inventowiz/frosty-flake-clone/frosty-flake-clone.kicad_pcb

## KiCad design frosty-flake-clone.kicad_pcb (2020-03-29)

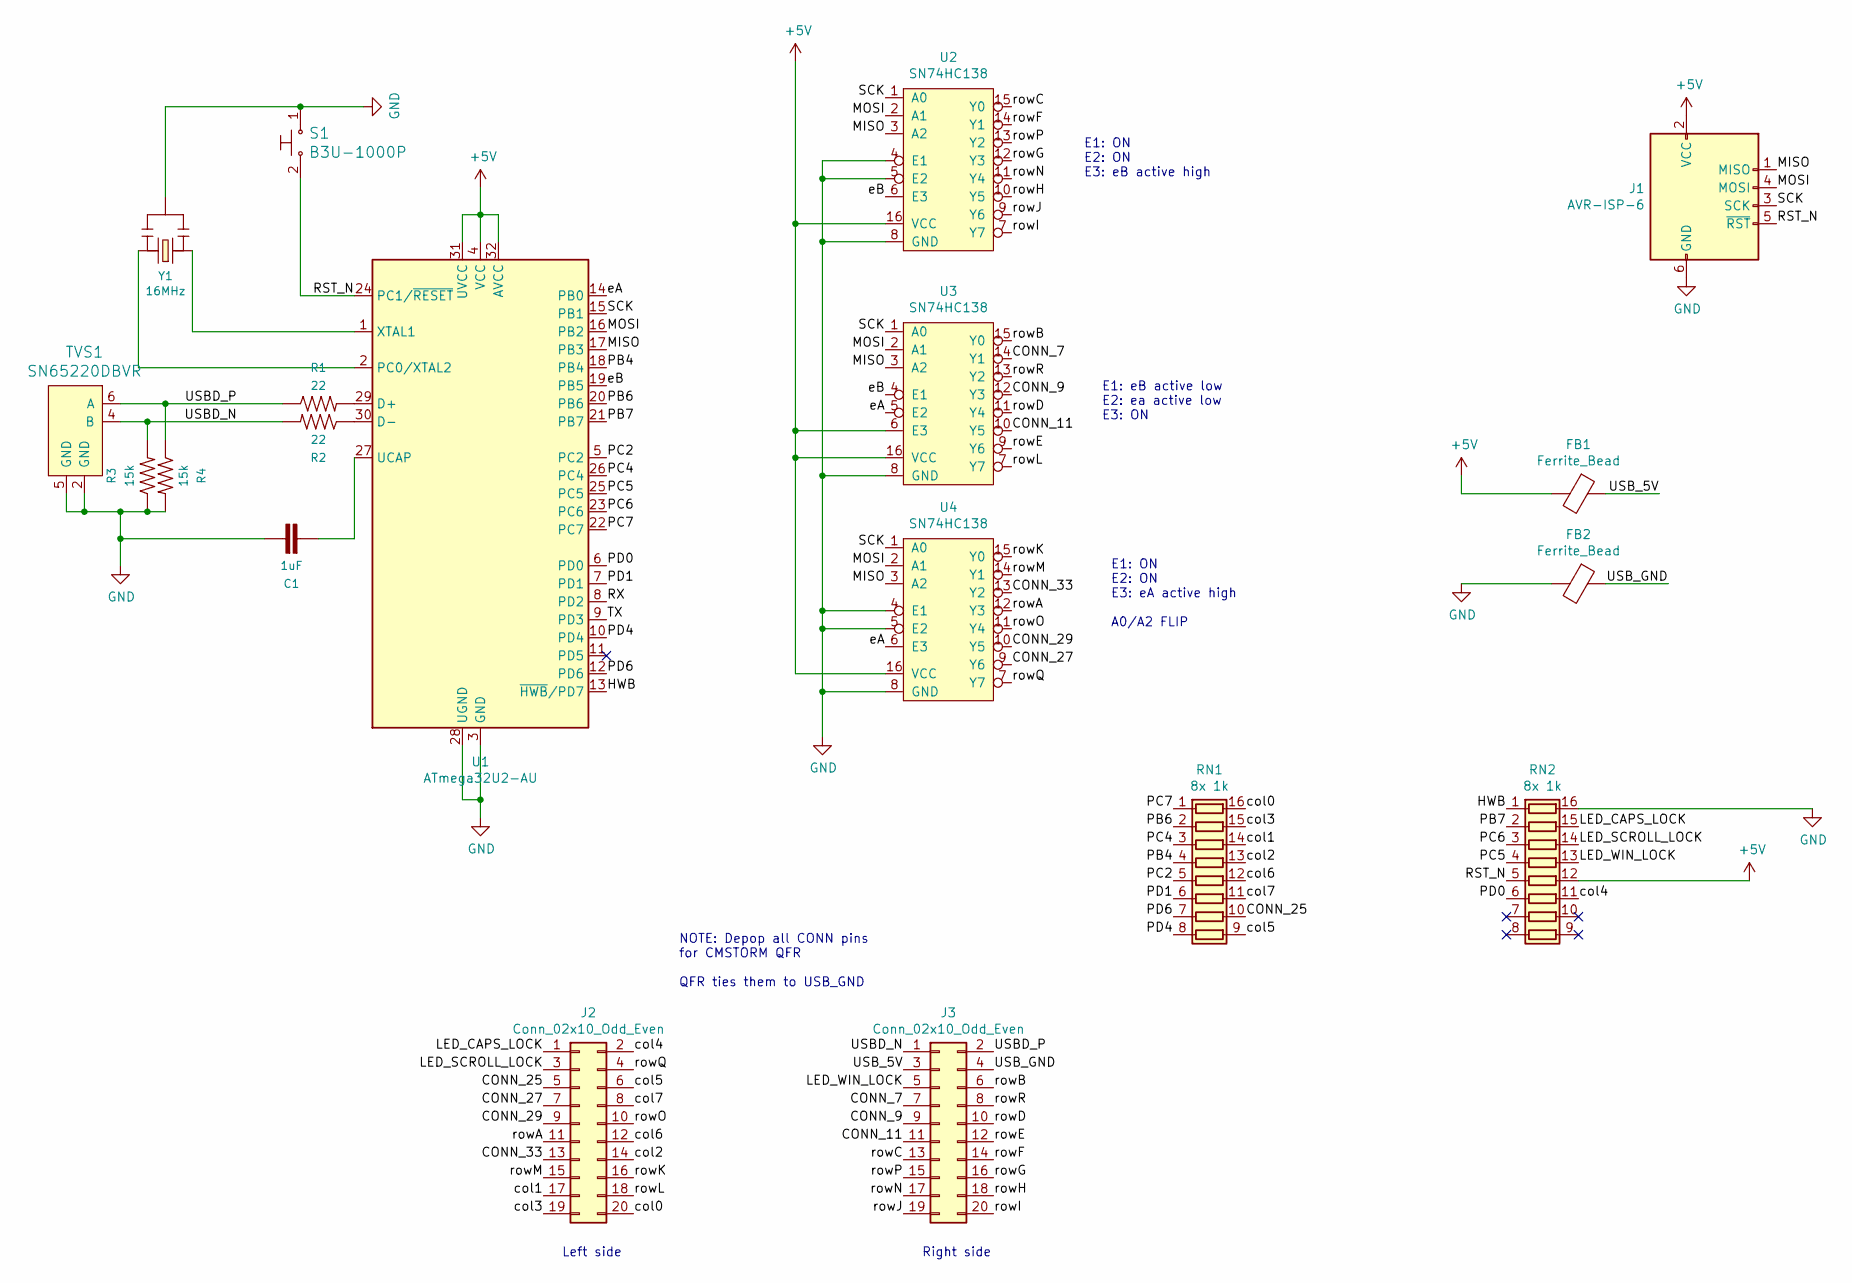
[picture p1: schematic frosty-flake-clone.sch]

Parts:
C1: 1uF; 0805
FB1, FB2: Ferrite_Bead; 0603
J1: AVR-ISP-6; 2X3
J2, J3: Conn_02x10_Odd_Even; PinHeader_2x10_P2.00mm_Vertical
R1, R2: 22; 0603
R3, R4: 15k; 0603
RN1, RN2: 8x 1k; R_Array_Convex_8x0602
S1: B3U-1000P; Switch_Tactile_SMD_B3U-1000P; MPN B3U-1000P; Digi-Key_PN SW1020CT-ND
TVS1: SN65220DBVR; SOT-23-6; MPN SN65220DBVR; Digi-Key_PN 296-9694-1-ND
U1: ATmega32U2-AU; TQFP-32_7x7mm_P0.8mm
U2, U3, U4: SN74HC138; TSSOP16
Y1: 16MHz; RESONATOR-SMD-3.2X1.3

Connections:
+5V: FB1.2, J1.2 (VCC), RN2.12 (R5.2), U1.4 (VCC), U1.31 (UVCC), U1.32 (AVCC), U2.16 (VCC), U3.6 (E3), U3.16 (VCC), U4.16 (VCC)
/CONN_7: J3.7, U3.14 (Y1)
/CONN_9: J3.9, U3.12 (Y3)
/CONN_11: J3.11, U3.10 (Y5)
/CONN_25: J2.5, RN1.10 (R7.2)
/CONN_27: J2.7, U4.9 (Y6)
/CONN_29: J2.9, U4.10 (Y5)
/CONN_33: J2.13, U4.13 (Y2)
/HWB: RN2.1 (R1.1), U1.13 (~HWB~/PD7)
/LED_CAPS_LOCK: J2.1, RN2.15 (R2.2)
/LED_SCROLL_LOCK: J2.3, RN2.14 (R3.2)
/LED_WIN_LOCK: J3.5, RN2.13 (R4.2)
/MISO: J1.1 (MISO), U1.17 (PB3), U2.3 (A2), U3.3 (A2), U4.3 (A2)
/MOSI: J1.4 (MOSI), U1.16 (PB2), U2.2 (A1), U3.2 (A1), U4.2 (A1)
/PB4: RN1.4 (R4.1), U1.18 (PB4)
/PB6: RN1.2 (R2.1), U1.20 (PB6)
/PB7: RN2.2 (R2.1), U1.21 (PB7)
/PC2: RN1.5 (R5.1), U1.5 (PC2)
/PC4: RN1.3 (R3.1), U1.26 (PC4)
/PC5: RN2.4 (R4.1), U1.25 (PC5)
/PC6: RN2.3 (R3.1), U1.23 (PC6)
/PC7: RN1.1 (R1.1), U1.22 (PC7)
/PD0: RN2.6 (R6.1), U1.6 (PD0)
/PD1: RN1.6 (R6.1), U1.7 (PD1)
/PD4: RN1.8 (R8.1), U1.10 (PD4)
/PD6: RN1.7 (R7.1), U1.12 (PD6)
/RST_N: J1.5 (~RST), RN2.5 (R5.1), S1.2, U1.24 (PC1/~RESET)
/RX: U1.8 (PD2)
/SCK: J1.3 (SCK), U1.15 (PB1), U2.1 (A0), U3.1 (A0), U4.1 (A0)
/TX: U1.9 (PD3)
/USBD_N: J3.1, R2.2, R3.2, TVS1.4 (B)
/USBD_P: J3.2, R1.1, R4.1, TVS1.6 (A)
/USB_5V: FB1.1, J3.3
/USB_GND: FB2.1, J3.4
/col0: J2.20, RN1.16 (R1.2)
/col1: J2.17, RN1.14 (R3.2)
/col2: J2.14, RN1.13 (R4.2)
/col3: J2.19, RN1.15 (R2.2)
/col4: J2.2, RN2.11 (R6.2)
/col5: J2.6, RN1.9 (R8.2)
/col6: J2.12, RN1.12 (R5.2)
/col7: J2.8, RN1.11 (R6.2)
/eA: U1.14 (PB0), U3.5 (E2), U4.6 (E3)
/eB: U1.19 (PB5), U2.6 (E3), U3.4 (E1)
/rowA: J2.11, U4.12 (Y3)
/rowB: J3.6, U3.15 (Y0)
/rowC: J3.13, U2.15 (Y0)
/rowD: J3.10, U3.11 (Y4)
/rowE: J3.12, U3.9 (Y6)
/rowF: J3.14, U2.14 (Y1)
/rowG: J3.16, U2.12 (Y3)
/rowH: J3.18, U2.10 (Y5)
/rowI: J3.20, U2.7 (Y7)
/rowJ: J3.19, U2.9 (Y6)
/rowK: J2.16, U4.15 (Y0)
/rowL: J2.18, U3.7 (Y7)
/rowM: J2.15, U4.14 (Y1)
/rowN: J3.17, U2.11 (Y4)
/rowO: J2.10, U4.11 (Y4)
/rowP: J3.15, U2.13 (Y2)
/rowQ: J2.4, U4.7 (Y7)
/rowR: J3.8, U3.13 (Y2)
GND: C1.1, FB2.2, J1.6 (GND), R3.1, R4.2, RN2.16 (R1.2), S1.1, TVS1.2 (GND), TVS1.5 (GND), U1.3 (GND), U1.28 (UGND), U2.4 (E1), U2.5 (E2), U2.8 (GND), U3.8 (GND), U4.4 (E1), U4.5 (E2), U4.8 (GND), Y1.2
unnamed: C1.2, U1.27 (UCAP)
unnamed: R1.2, U1.29 (D+)
unnamed: R2.1, U1.30 (D-)
unnamed: U1.1 (XTAL1), Y1.1
unnamed: U1.2 (PC0/XTAL2), Y1.3

Notes on the sheet:
Right side
Left side
E1: eB active low E2: ea active low E3: ON
E1: ON E2: ON E3: eB active high
E1: ON E2: ON E3: eA active high A0/A2 FLIP
NOTE: Depop all CONN pins for CMSTORM QFR QFR ties them to USB_GND

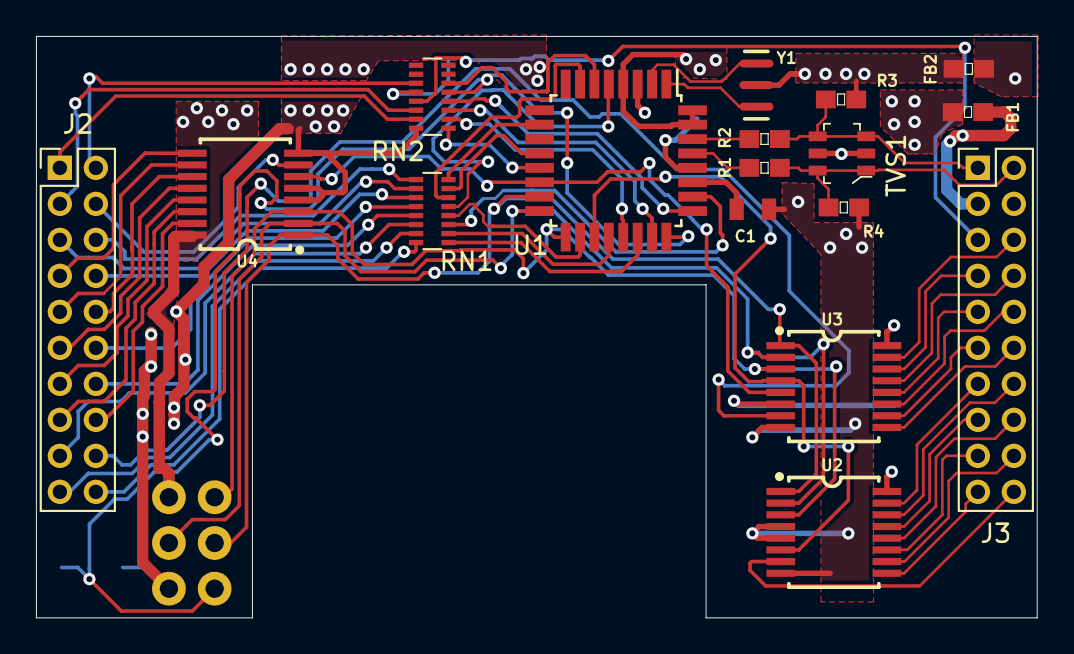
[picture p2: board frosty-flake-clone.kicad_pcb from above]

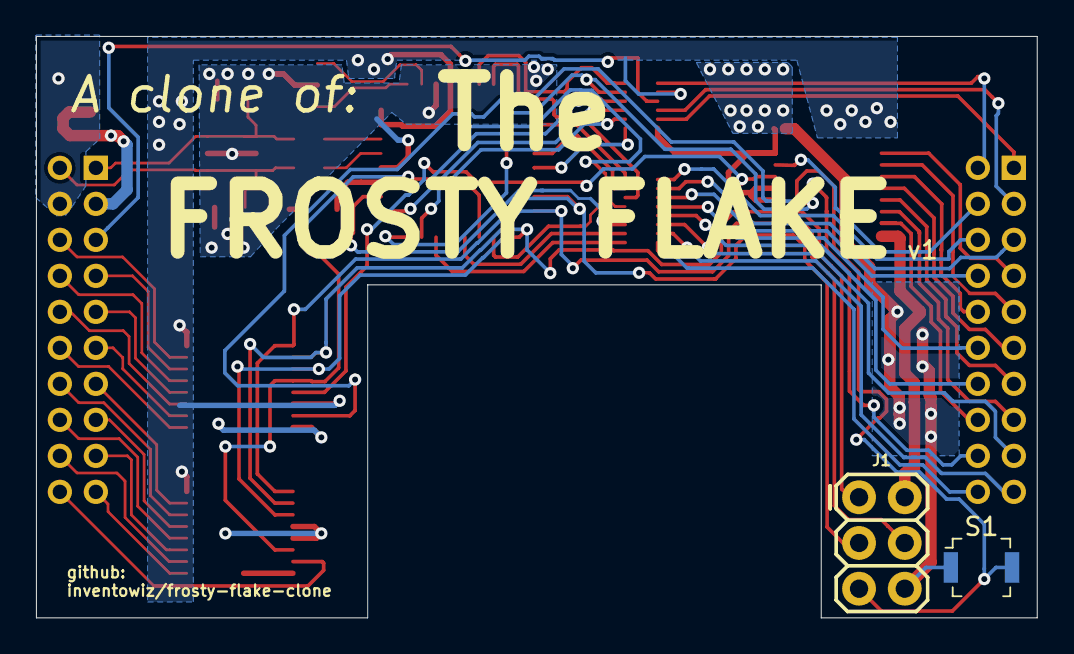
[picture p3: board frosty-flake-clone.kicad_pcb from below]

Board: 2 copper layers, 55.6 x 32.3 mm, 19 parts (2 on the bottom side), 66 nets.
