inventowiz/frosty-flake-clone/(threads)

Thread 1 (2020-03-29):

Add 10uF bulk cap after ferrite, remove GND ferrite

inventowiz, 2020-03-29:
Power integrity issue created when running the board under certain conditions due to 600Ohm impedance of the ferrites. GND ferrite not needed

Thread 2 (2020-03-29):

Add resistor options for QFR extra GND pins

inventowiz, 2020-03-29:
Currently all the CONN* pins need to be pulled to avoid board shorts
